tfry-git/ergometrino/(commit log)

2018-02-16 More documentation, and add battery level indication.
2018-02-17 Fix silly overflow issue while reading best time recordings
    [ergometrino.ino]
2018-02-18 Add optional button to switch between different speed references
